tyk1225/flydek/FLYDEK-v1.kicad_pcb

## KiCad design FLYDEK-v1.kicad_pcb (2026-11-13)

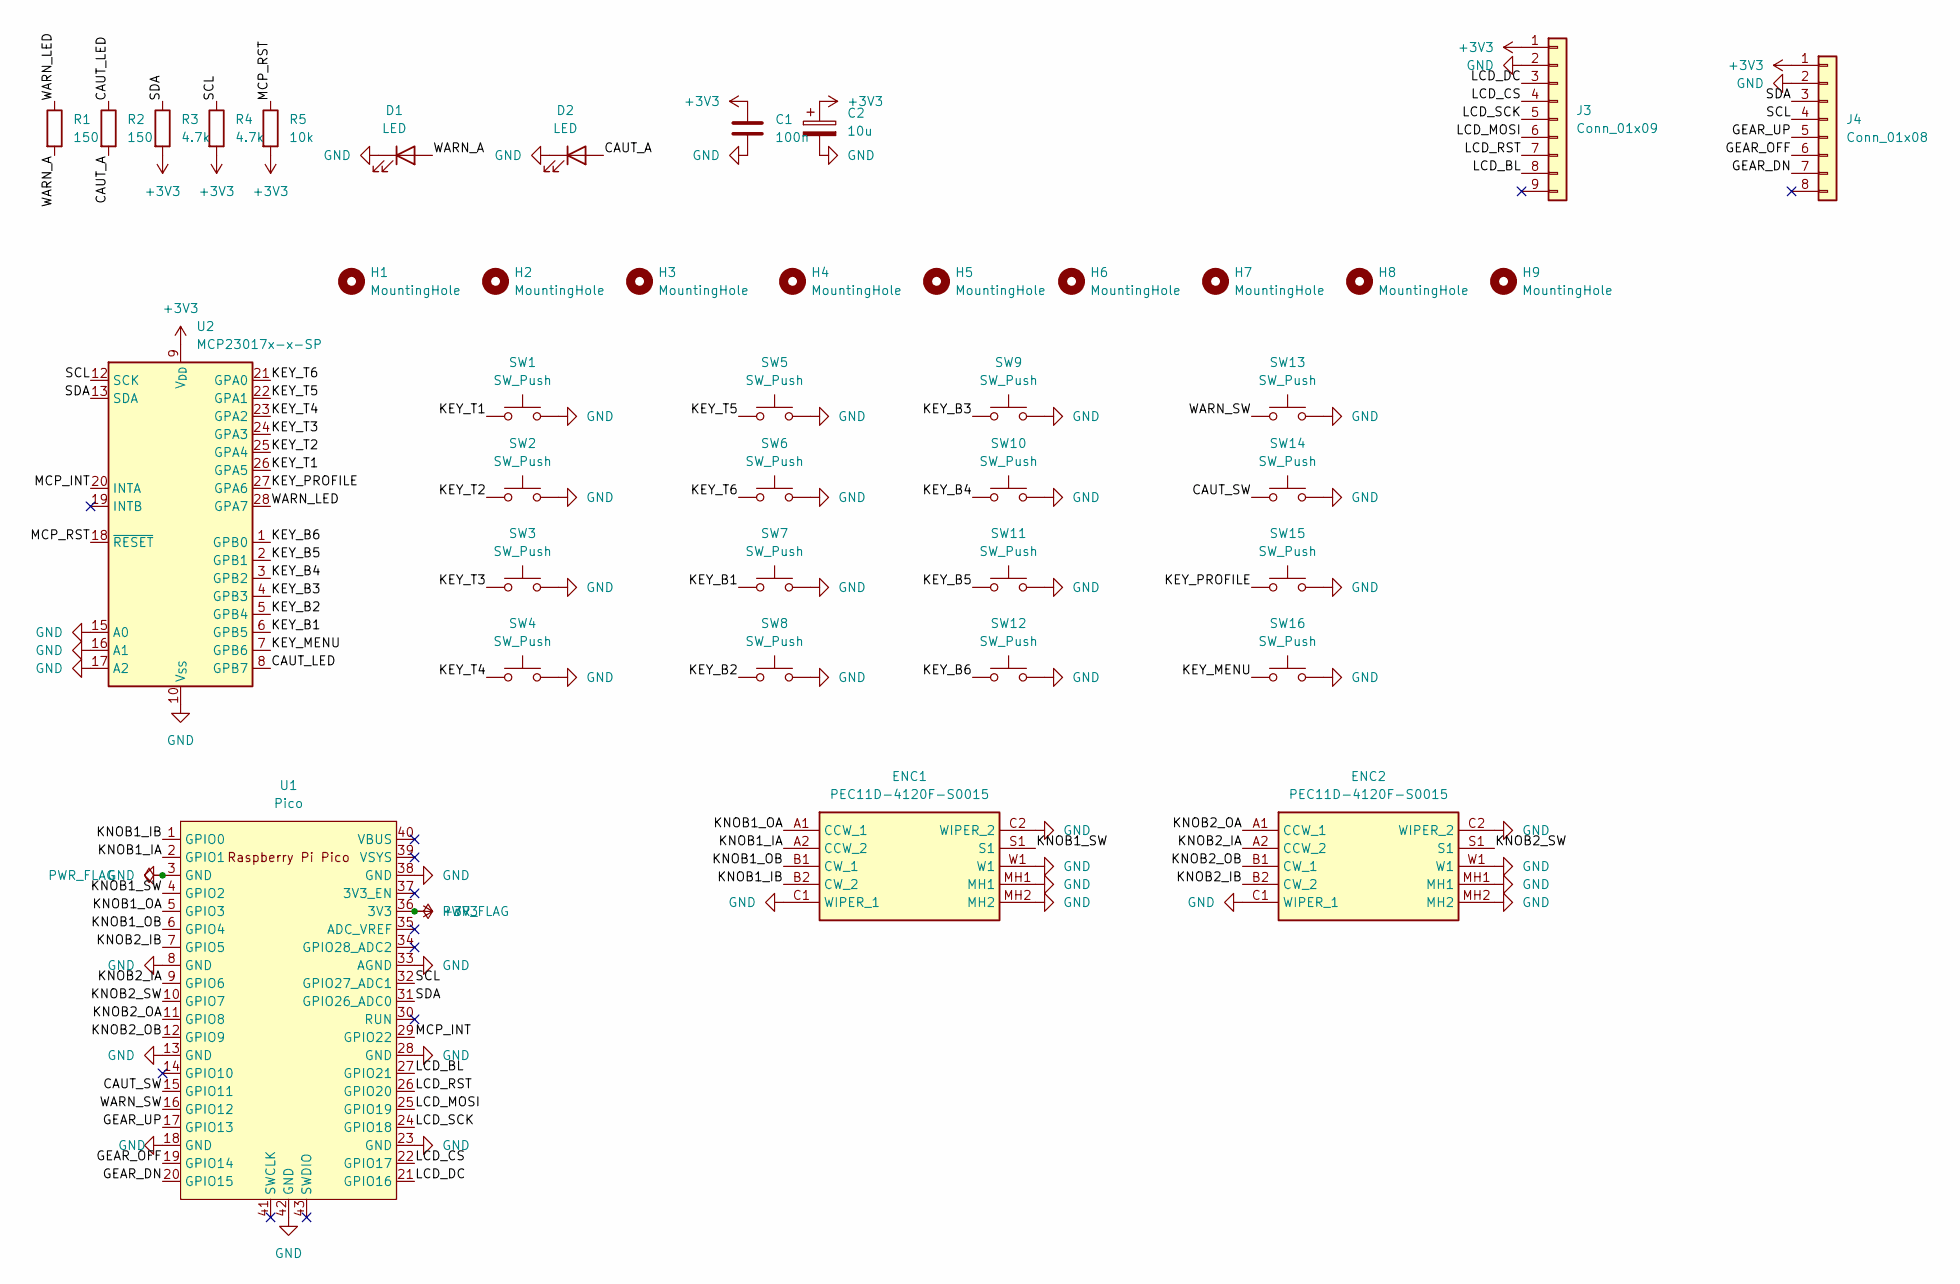
[picture p1: schematic FLYDEK-v1.kicad_sch]

Parts:
C1: 100n; C_Disc_D5.0mm_W2.5mm_P5.00mm
C2: 10u; CP_Radial_D5.0mm_P2.00mm
D1, D2: LED; LED_D3.0mm
ENC1, ENC2: PEC11D-4120F-S0015; PEC11D4120FS0015; Manufacturer_Part_Number PEC11D-4120F-S0015
H1, H2, H3, H4, H5, H6, H7, H8, H9: MountingHole; MountingHole_3.2mm_M3
J3: Conn_01x09; PinHeader_1x09_P2.54mm_Vertical
J4: Conn_01x08; JST_XH_S8B-XH-A_1x08_P2.50mm_Horizontal
R1, R2: 150; R_Axial_DIN0207_L6.3mm_D2.5mm_P10.16mm_Horizontal
R3, R4: 4.7k; R_Axial_DIN0207_L6.3mm_D2.5mm_P10.16mm_Horizontal
R5: 10k; R_Axial_DIN0207_L6.3mm_D2.5mm_P10.16mm_Horizontal
SW1, SW2, SW3, SW4, SW5, SW6, SW7, SW8, SW9, SW10, SW11, SW12, SW13, SW14, SW15, SW16: SW_Push; SW_PUSH-12mm
U1: Pico; RPi_Pico_SMD_TH
U2: MCP23017x-x-SP; DIP-28_W7.62mm

Connections:
+3V3: C1.1, C2.1, J3.1, J4.1, R3.2, R4.2, R5.2, U1.36 (3V3), U2.9 (V_{DD})
/CAUT_A: D2.2 (A), R2.2
/CAUT_LED: R2.1, U2.8 (GPB7)
/CAUT_SW: SW14.1, U1.15 (GPIO11)
/GEAR_DN: J4.7, U1.20 (GPIO15)
/GEAR_OFF: J4.6, U1.19 (GPIO14)
/GEAR_UP: J4.5, U1.17 (GPIO13)
/KEY_B1: SW7.1, U2.6 (GPB5)
/KEY_B2: SW8.1, U2.5 (GPB4)
/KEY_B3: SW9.1, U2.4 (GPB3)
/KEY_B4: SW10.1, U2.3 (GPB2)
/KEY_B5: SW11.1, U2.2 (GPB1)
/KEY_B6: SW12.1, U2.1 (GPB0)
/KEY_MENU: SW16.1, U2.7 (GPB6)
/KEY_PROFILE: SW15.1, U2.27 (GPA6)
/KEY_T1: SW1.1, U2.26 (GPA5)
/KEY_T2: SW2.1, U2.25 (GPA4)
/KEY_T3: SW3.1, U2.24 (GPA3)
/KEY_T4: SW4.1, U2.23 (GPA2)
/KEY_T5: SW5.1, U2.22 (GPA1)
/KEY_T6: SW6.1, U2.21 (GPA0)
/KNOB1_IA: ENC1.A2 (CCW_2), U1.2 (GPIO1)
/KNOB1_IB: ENC1.B2 (CW_2), U1.1 (GPIO0)
/KNOB1_OA: ENC1.A1 (CCW_1), U1.5 (GPIO3)
/KNOB1_OB: ENC1.B1 (CW_1), U1.6 (GPIO4)
/KNOB1_SW: ENC1.S1, U1.4 (GPIO2)
/KNOB2_IA: ENC2.A2 (CCW_2), U1.9 (GPIO6)
/KNOB2_IB: ENC2.B2 (CW_2), U1.7 (GPIO5)
/KNOB2_OA: ENC2.A1 (CCW_1), U1.11 (GPIO8)
/KNOB2_OB: ENC2.B1 (CW_1), U1.12 (GPIO9)
/KNOB2_SW: ENC2.S1, U1.10 (GPIO7)
/LCD_BL: J3.8, U1.27 (GPIO21)
/LCD_CS: J3.4, U1.22 (GPIO17)
/LCD_DC: J3.3, U1.21 (GPIO16)
/LCD_MOSI: J3.6, U1.25 (GPIO19)
/LCD_RST: J3.7, U1.26 (GPIO20)
/LCD_SCK: J3.5, U1.24 (GPIO18)
/MCP_INT: U1.29 (GPIO22), U2.20 (INTA)
/MCP_RST: R5.1, U2.18 (~RESET)
/SCL: J4.4, R4.1, U1.32 (GPIO27_ADC1), U2.12 (SCK)
/SDA: J4.3, R3.1, U1.31 (GPIO26_ADC0), U2.13 (SDA)
/WARN_A: D1.2 (A), R1.2
/WARN_LED: R1.1, U2.28 (GPA7)
/WARN_SW: SW13.1, U1.16 (GPIO12)
GND: C1.2, C2.2, D1.1 (K), D2.1 (K), ENC1.C1 (WIPER_1), ENC1.C2 (WIPER_2), ENC1.MH1, ENC1.MH2, ENC1.W1, ENC2.C1 (WIPER_1), ENC2.C2 (WIPER_2), ENC2.MH1, ENC2.MH2, ENC2.W1, J3.2, J4.2, SW1.2, SW2.2, SW3.2, SW4.2, SW5.2, SW6.2, SW7.2, SW8.2, SW9.2, SW10.2, SW11.2, SW12.2, SW13.2, SW14.2, SW15.2, SW16.2, U1.3 (GND), U1.8 (GND), U1.13 (GND), U1.18 (GND), U1.23 (GND), U1.28 (GND), U1.33 (AGND), U1.38 (GND), U1.42 (GND), U2.10 (V_{SS}), U2.15 (A0), U2.16 (A1), U2.17 (A2)

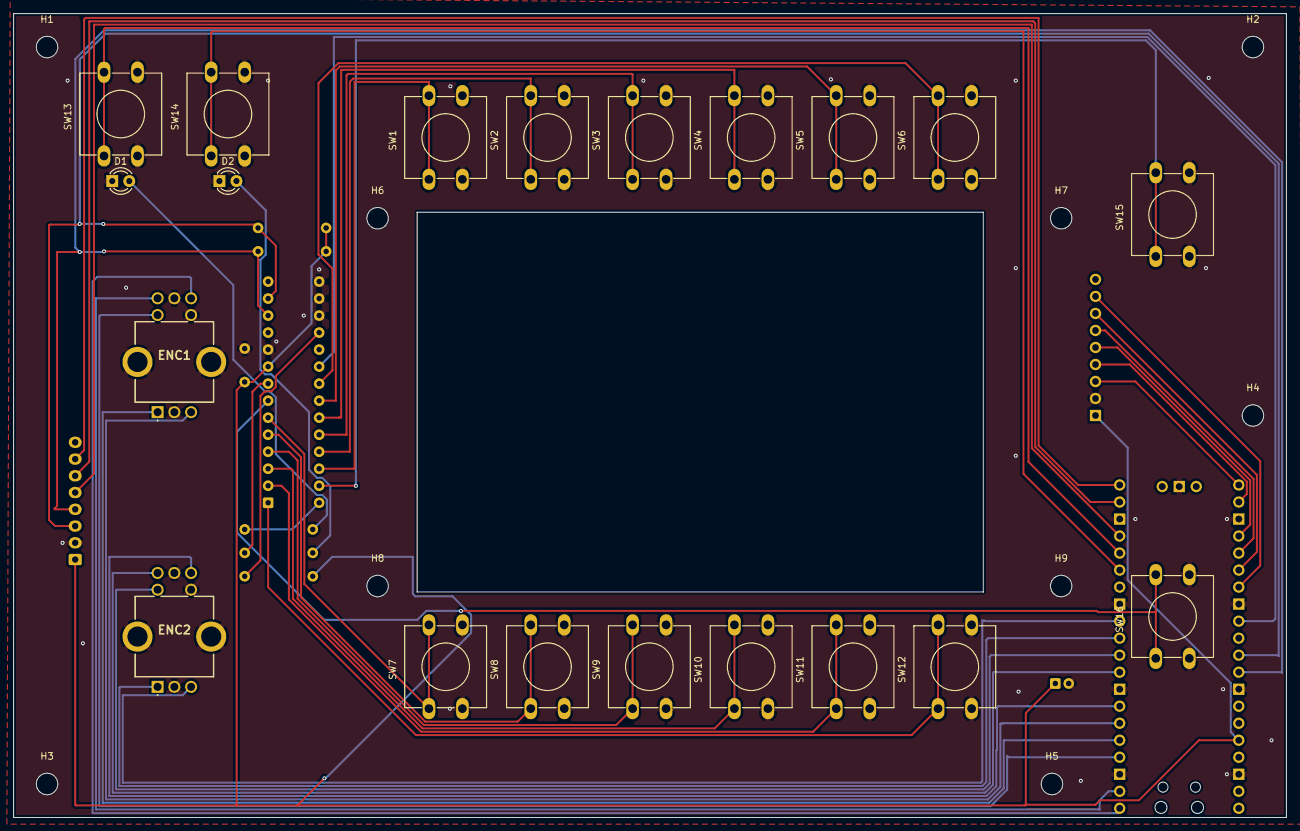
[picture p2: board FLYDEK-v1.kicad_pcb from above]

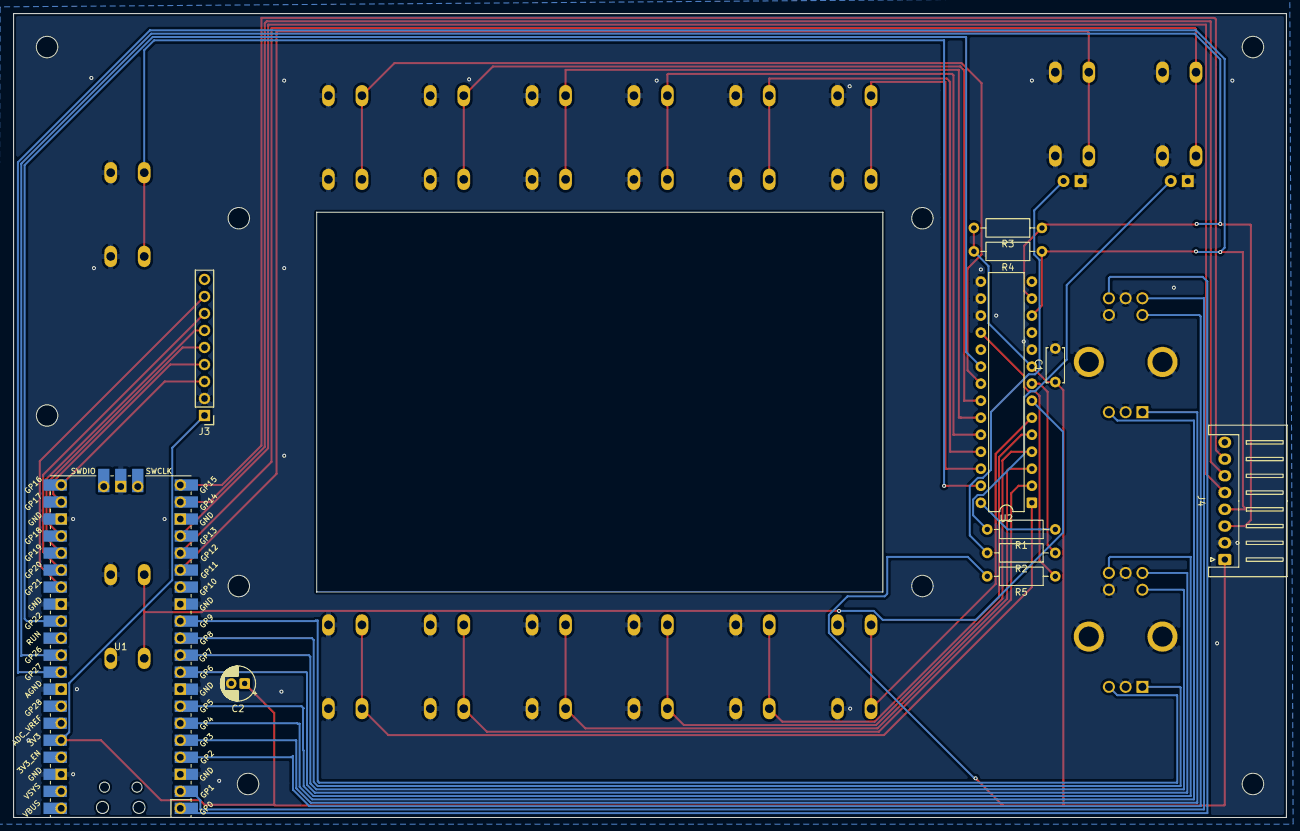
[picture p3: board FLYDEK-v1.kicad_pcb from below]

Board: 2 copper layers, 190.0 x 120.0 mm, 40 parts (11 on the bottom side), 45 nets.
